ekoppen/ha-personal/bilresa-wandschakelaar/print/B1_blindplaat_1doos/B1_blindplaat_1doos_deel1_basis.3mf

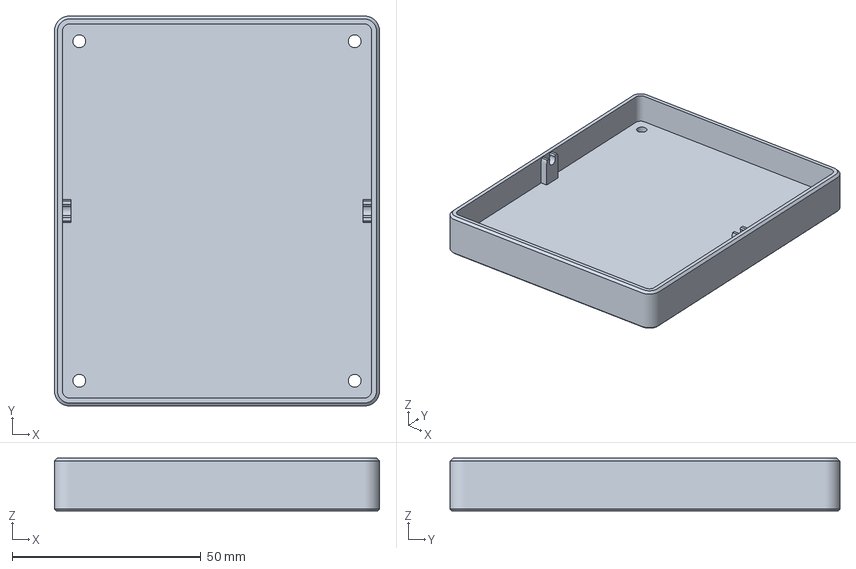
[picture p3: CAD file, 2026-11-01]
bilresa-wandschakelaar/print/B1_blindplaat_1doos/B1_blindplaat_1doos_deel1_basis.3mf
86.2 x 103.4 x 14.1 mm
