ekoppen/ha-personal/bilresa-wandschakelaar/print/D2_montagebakje_2_losse_modules/D2_montagebakje_2_losse_modules.3mf

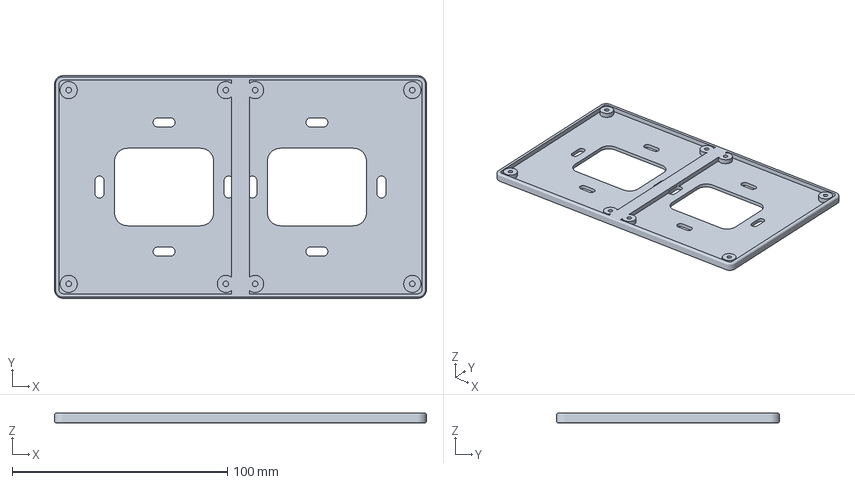
[picture p4: CAD file, 2026-11-01]
bilresa-wandschakelaar/print/D2_montagebakje_2_losse_modules/D2_montagebakje_2_losse_modules.3mf
172.8 x 103.4 x 4.65 mm
