ekoppen/ha-personal/bilresa-wandschakelaar/print/V1_enkel_1doos/STL/5_knop_dopje_normaal.stl

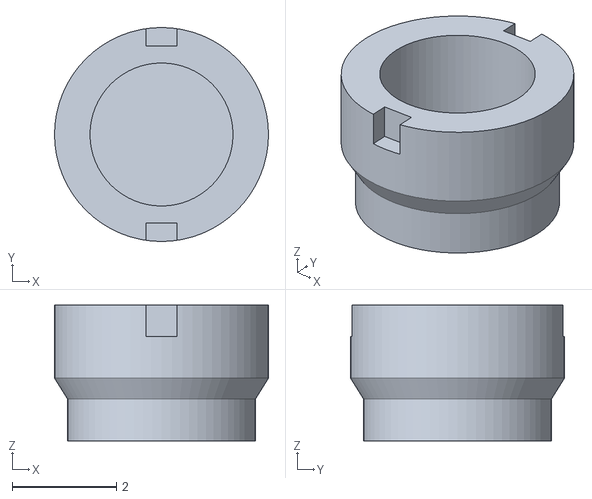
[picture p5: CAD file, 2026-11-01]
bilresa-wandschakelaar/print/V1_enkel_1doos/STL/5_knop_dopje_normaal.stl
4.10 x 4.10 x 2.60
