ekoppen/ha-personal/bilresa-wandschakelaar/print/V1_enkel_1doos/V1_enkel_1doos_deel2_montagebakje.3mf

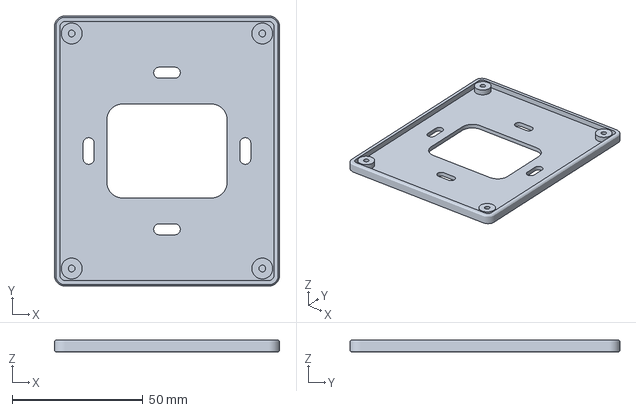
[picture p6: CAD file, 2026-11-01]
bilresa-wandschakelaar/print/V1_enkel_1doos/V1_enkel_1doos_deel2_montagebakje.3mf
86.2 x 103.4 x 4.65 mm
