ekoppen/ha-personal/bilresa-wandschakelaar/print/V2_dubbel_1doos/V2_dubbel_1doos_deel1_basis.3mf

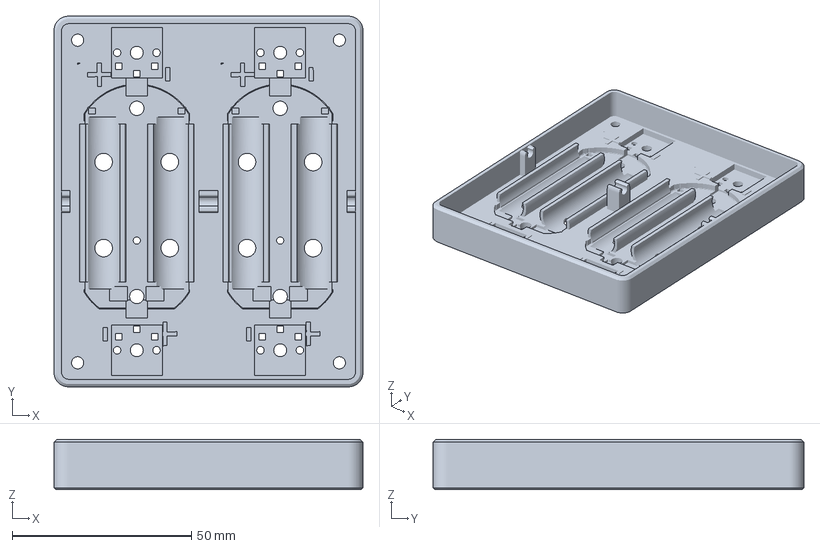
[picture p7: CAD file, 2026-11-01]
bilresa-wandschakelaar/print/V2_dubbel_1doos/V2_dubbel_1doos_deel1_basis.3mf
86.2 x 103.4 x 14.1 mm
