ekoppen/ha-personal/bilresa-wandschakelaar/print/V3_dubbel_2dozen/V3_dubbel_2dozen_deel1_basis.3mf

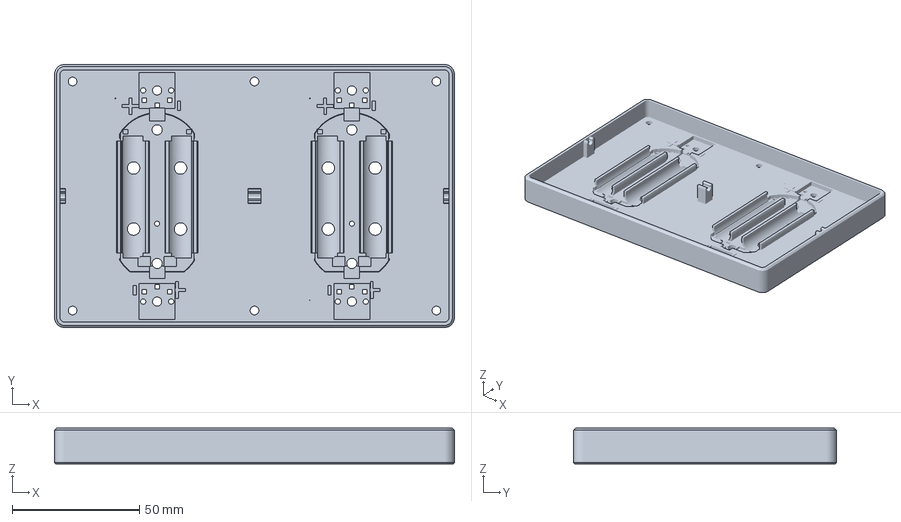
[picture p8: CAD file, 2026-11-01]
bilresa-wandschakelaar/print/V3_dubbel_2dozen/V3_dubbel_2dozen_deel1_basis.3mf
157.2 x 103.4 x 14.1 mm
