ekoppen/ha-personal/bilresa-wandschakelaar/print/V4_vierdubbel_2dozen/STL/4_choc_dopje_normaal.stl

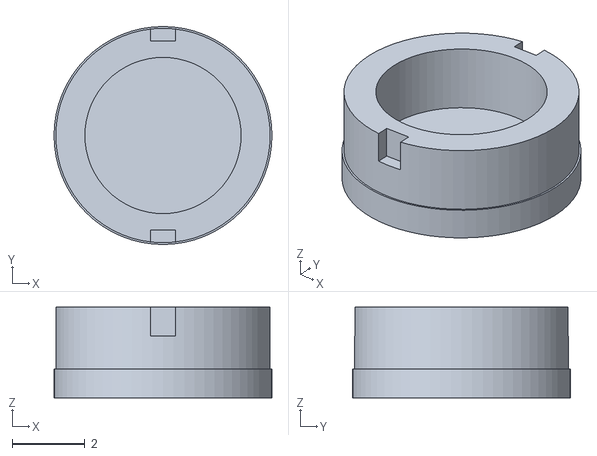
[picture p9: CAD file, 2026-11-01]
bilresa-wandschakelaar/print/V4_vierdubbel_2dozen/STL/4_choc_dopje_normaal.stl
6.00 x 6.00 x 2.50
