ekoppen/ha-personal/bilresa-wandschakelaar/print/V4_vierdubbel_2dozen/V4_vierdubbel_2dozen_deel3_wippen_dopjes_normaal.3mf

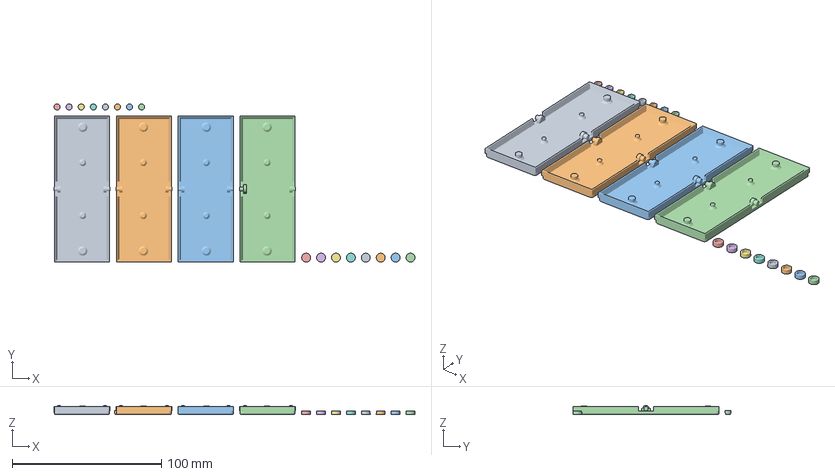
[picture p10: CAD file, 2026-11-01]
bilresa-wandschakelaar/print/V4_vierdubbel_2dozen/V4_vierdubbel_2dozen_deel3_wippen_dopjes_normaal.3mf
242.1 x 106.1 x 6.20 mm
wip1
wip2
wip3
wip4
choc_dopje_normaal_1
choc_dopje_normaal_2
choc_dopje_normaal_3
choc_dopje_normaal_4
choc_dopje_normaal_5
choc_dopje_normaal_6
choc_dopje_normaal_7
choc_dopje_normaal_8
knop_dopje_normaal_1
knop_dopje_normaal_2
knop_dopje_normaal_3
knop_dopje_normaal_4
knop_dopje_normaal_5
knop_dopje_normaal_6
knop_dopje_normaal_7
knop_dopje_normaal_8
