ekoppen/ha-personal/bilresa-wandschakelaar/print/V5_enkel_2dozen_blind/V5_enkel_2dozen_blind_deel1_basis.3mf

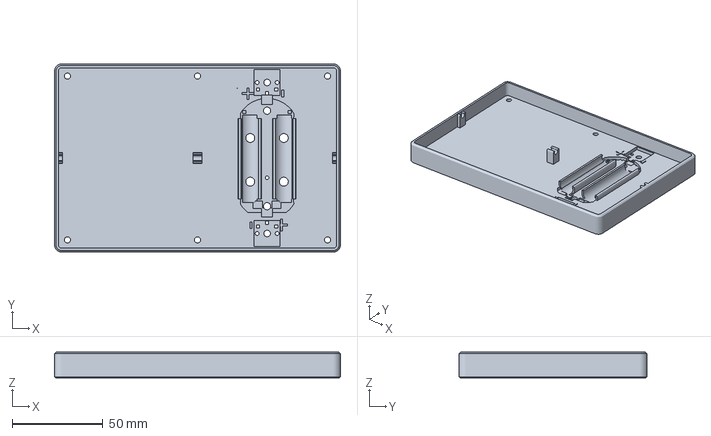
[picture p11: CAD file, 2026-11-01]
bilresa-wandschakelaar/print/V5_enkel_2dozen_blind/V5_enkel_2dozen_blind_deel1_basis.3mf
157.2 x 103.4 x 14.1 mm
