ekoppen/ha-personal/bilresa-wandschakelaar/print/B1_blindplaat_1doos/B1_blindplaat_1doos_deel3_blindplaat.3mf

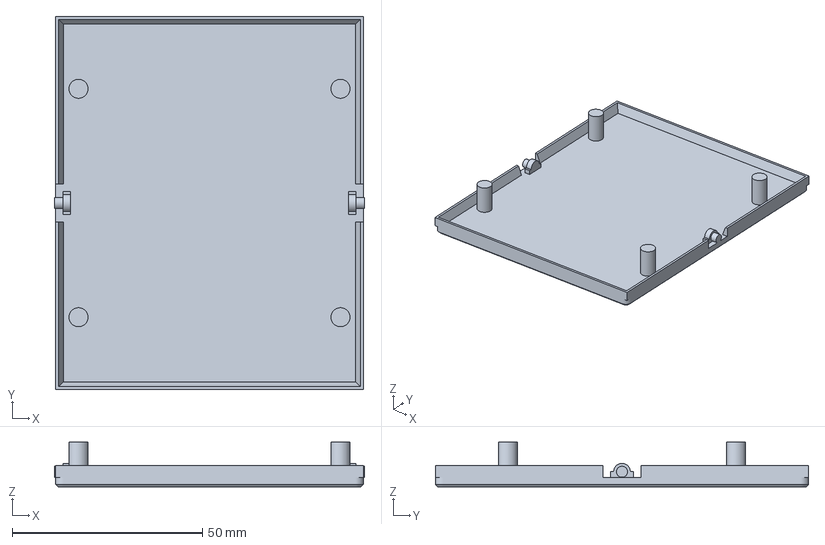
[picture p12: CAD file, 2026-11-01]
bilresa-wandschakelaar/print/B1_blindplaat_1doos/B1_blindplaat_1doos_deel3_blindplaat.3mf
81.4 x 98.0 x 11.8 mm
