ekoppen/ha-personal/bilresa-wandschakelaar/print/V1_enkel_1doos/STL/4_choc_dopje_dun.stl

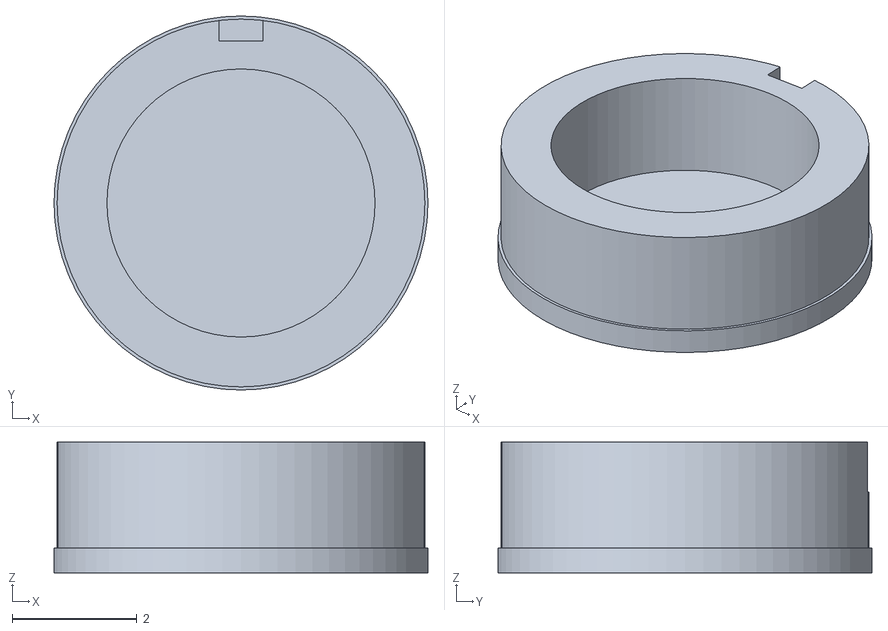
[picture p13: CAD file, 2026-11-01]
bilresa-wandschakelaar/print/V1_enkel_1doos/STL/4_choc_dopje_dun.stl
6.00 x 6.00 x 2.10
