ekoppen/ha-personal/bilresa-wandschakelaar/print/V1_enkel_1doos/V1_enkel_1doos_deel4_reserve_dopjes_dun_dik.3mf

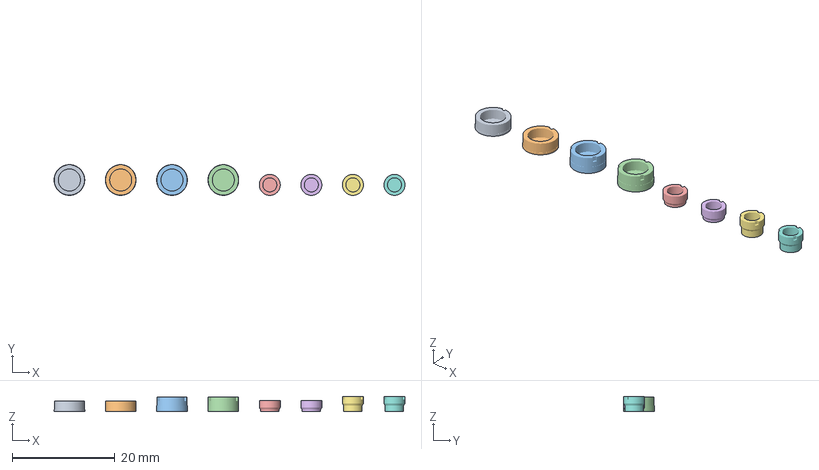
[picture p14: CAD file, 2026-11-01]
bilresa-wandschakelaar/print/V1_enkel_1doos/V1_enkel_1doos_deel4_reserve_dopjes_dun_dik.3mf
68.4 x 6.00 x 3.00 mm
choc_dopje_dun_1
choc_dopje_dun_2
choc_dopje_dik_1
choc_dopje_dik_2
knop_dopje_dun_1
knop_dopje_dun_2
knop_dopje_dik_1
knop_dopje_dik_2
