ekoppen/ha-personal/bilresa-wandschakelaar/print/V2_dubbel_1doos/STL/3_wip_1.stl

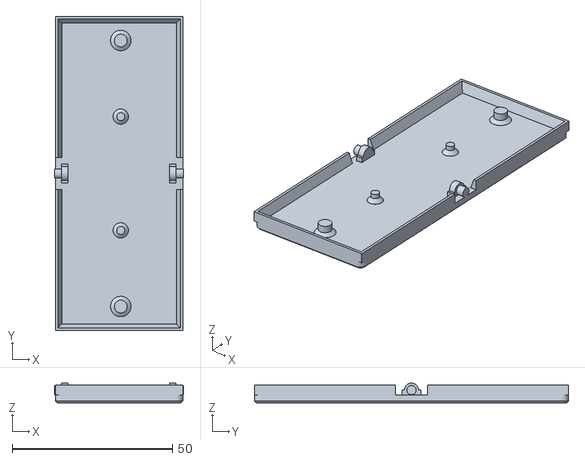
[picture p15: CAD file, 2026-11-01]
bilresa-wandschakelaar/print/V2_dubbel_1doos/STL/3_wip_1.stl
40.3 x 98.0 x 6.20
