ekoppen/ha-personal/bilresa-wandschakelaar/print/V3_dubbel_2dozen/V3_dubbel_2dozen_deel4_reserve_dopjes_dun_dik.3mf

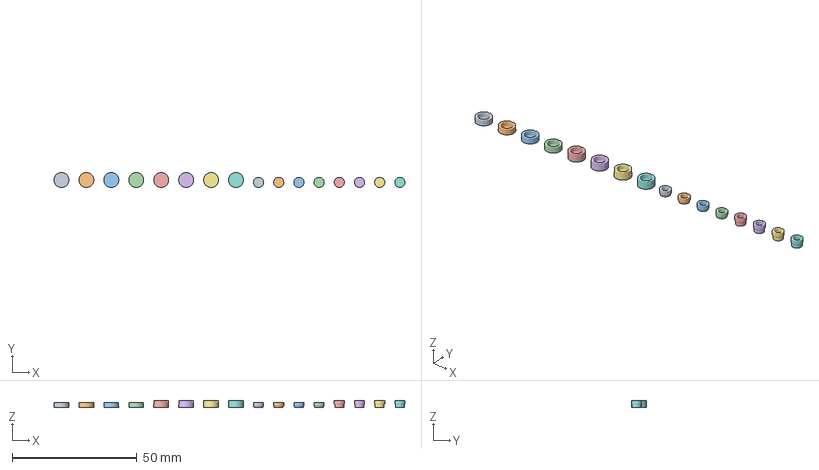
[picture p18: CAD file, 2026-11-01]
bilresa-wandschakelaar/print/V3_dubbel_2dozen/V3_dubbel_2dozen_deel4_reserve_dopjes_dun_dik.3mf
140.8 x 6.00 x 3.00 mm
choc_dopje_dun_1
choc_dopje_dun_2
choc_dopje_dun_3
choc_dopje_dun_4
choc_dopje_dik_1
choc_dopje_dik_2
choc_dopje_dik_3
choc_dopje_dik_4
knop_dopje_dun_1
knop_dopje_dun_2
knop_dopje_dun_3
knop_dopje_dun_4
knop_dopje_dik_1
knop_dopje_dik_2
knop_dopje_dik_3
knop_dopje_dik_4
