ekoppen/ha-personal/bilresa-wandschakelaar/print/V4_vierdubbel_2dozen/STL/2_montagebakje.stl

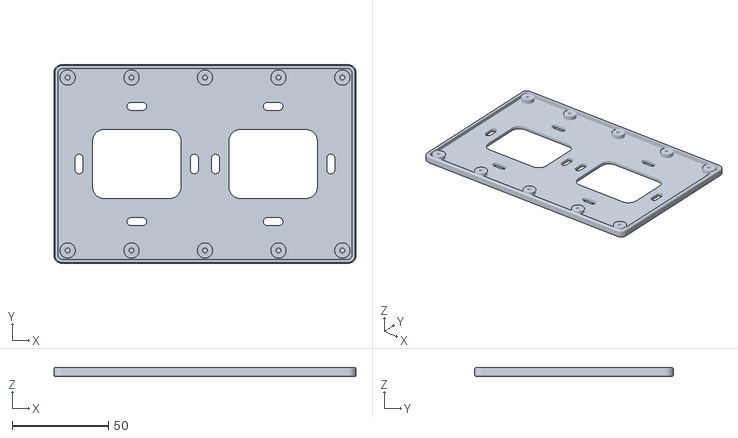
[picture p19: CAD file, 2026-11-01]
bilresa-wandschakelaar/print/V4_vierdubbel_2dozen/STL/2_montagebakje.stl
157.2 x 103.4 x 4.65
