ekoppen/ha-personal/bilresa-wandschakelaar/print/V5_enkel_2dozen_blind/STL/3_wip_2.stl

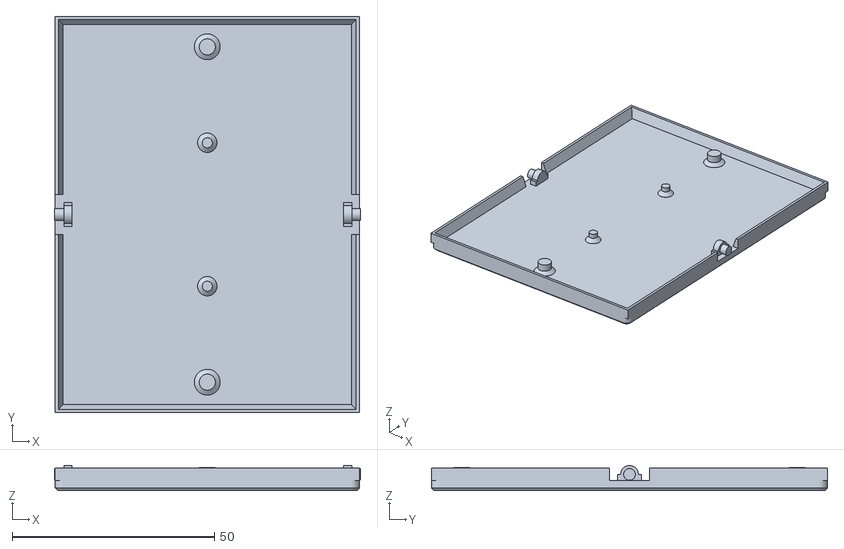
[picture p20: CAD file, 2026-11-01]
bilresa-wandschakelaar/print/V5_enkel_2dozen_blind/STL/3_wip_2.stl
75.8 x 98.0 x 6.20
