ekoppen/ha-personal/bilresa-wandschakelaar/print/V3_dubbel_2dozen/V3_dubbel_2dozen_deel3_wippen_dopjes_normaal.3mf

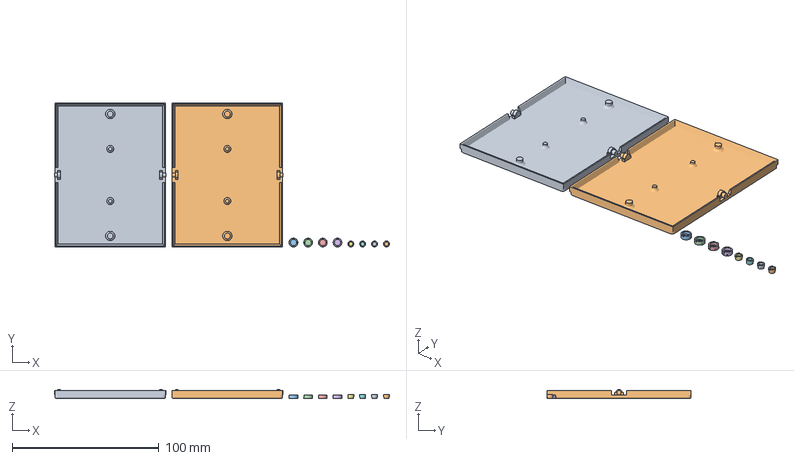
[picture p22: CAD file, 2026-11-01]
bilresa-wandschakelaar/print/V3_dubbel_2dozen/V3_dubbel_2dozen_deel3_wippen_dopjes_normaal.3mf
228.0 x 98.0 x 6.20 mm
wip1
wip2
choc_dopje_normaal_1
choc_dopje_normaal_2
choc_dopje_normaal_3
choc_dopje_normaal_4
knop_dopje_normaal_1
knop_dopje_normaal_2
knop_dopje_normaal_3
knop_dopje_normaal_4
