ekoppen/ha-personal/bilresa-wandschakelaar/print/V4_vierdubbel_2dozen/V4_vierdubbel_2dozen_deel1_basis.3mf

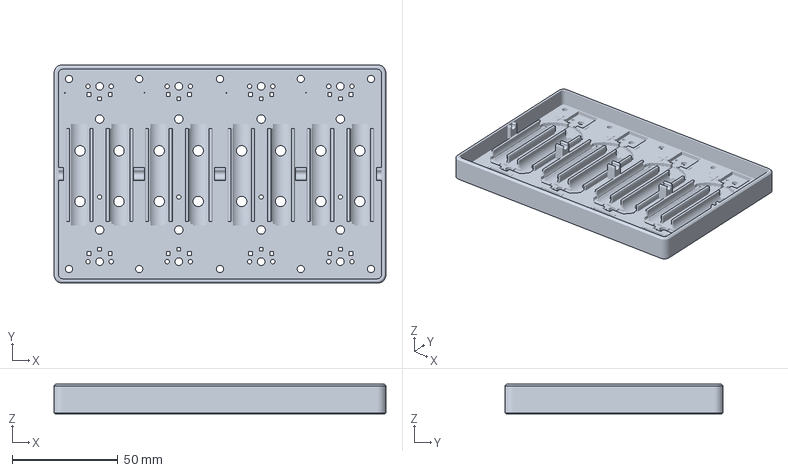
[picture p24: CAD file, 2026-11-01]
bilresa-wandschakelaar/print/V4_vierdubbel_2dozen/V4_vierdubbel_2dozen_deel1_basis.3mf
157.2 x 103.4 x 14.1 mm
