ekoppen/ha-personal/bilresa-wandschakelaar/print/V5_enkel_2dozen_blind/STL/5_knop_dopje_dun.stl

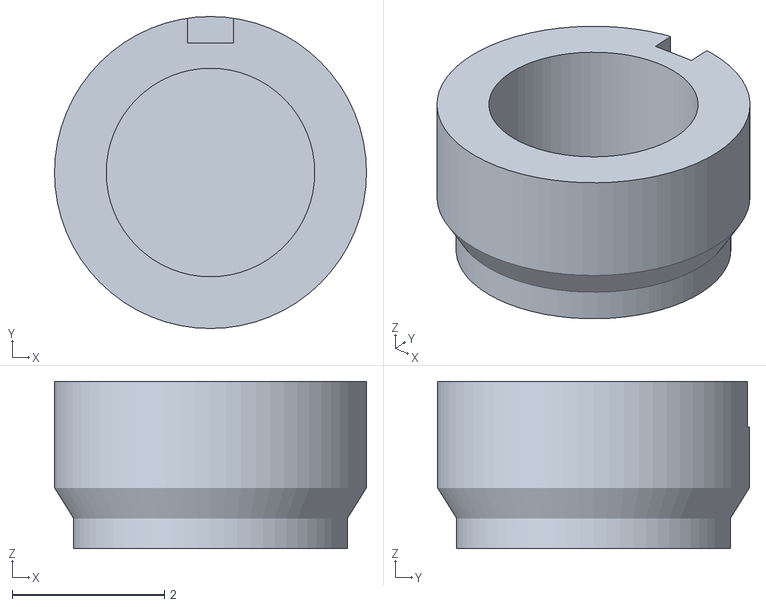
[picture p25: CAD file, 2026-11-01]
bilresa-wandschakelaar/print/V5_enkel_2dozen_blind/STL/5_knop_dopje_dun.stl
4.10 x 4.10 x 2.20
