ekoppen/ha-personal/bilresa-wandschakelaar/print/V1_enkel_1doos/V1_enkel_1doos_deel3_wippen_dopjes_normaal.3mf

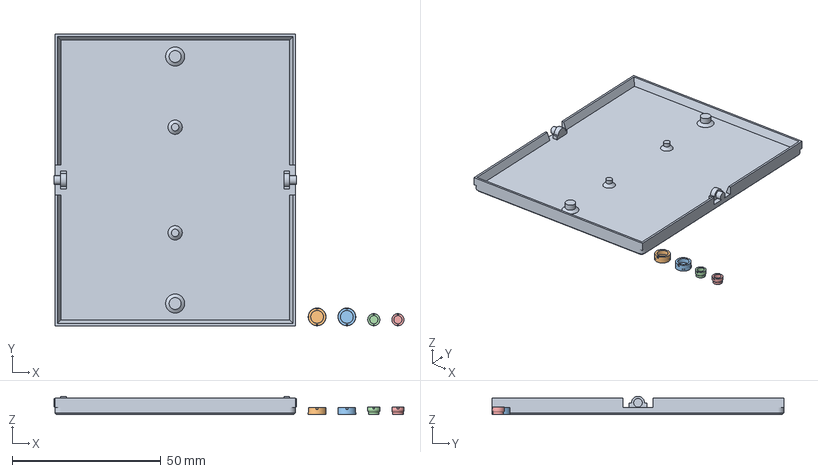
[picture p26: CAD file, 2026-11-01]
bilresa-wandschakelaar/print/V1_enkel_1doos/V1_enkel_1doos_deel3_wippen_dopjes_normaal.3mf
117.6 x 98.0 x 6.20 mm
wip1
choc_dopje_normaal_1
choc_dopje_normaal_2
knop_dopje_normaal_1
knop_dopje_normaal_2
