ekoppen/ha-personal/bilresa-wandschakelaar/print/V4_vierdubbel_2dozen/V4_vierdubbel_2dozen_deel4_reserve_dopjes_dun_dik.3mf

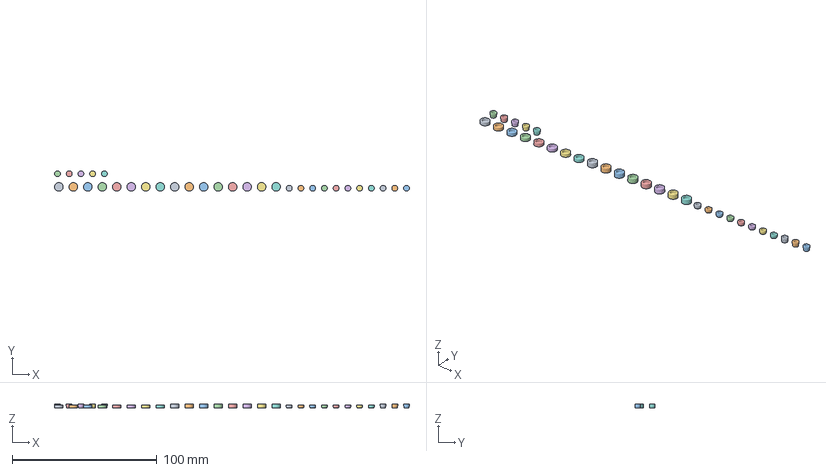
[picture p27: CAD file, 2026-11-01]
bilresa-wandschakelaar/print/V4_vierdubbel_2dozen/V4_vierdubbel_2dozen_deel4_reserve_dopjes_dun_dik.3mf
245.1 x 14.1 x 3.00 mm
choc_dopje_dun_1
choc_dopje_dun_2
choc_dopje_dun_3
choc_dopje_dun_4
choc_dopje_dun_5
choc_dopje_dun_6
choc_dopje_dun_7
choc_dopje_dun_8
choc_dopje_dik_1
choc_dopje_dik_2
choc_dopje_dik_3
choc_dopje_dik_4
choc_dopje_dik_5
choc_dopje_dik_6
choc_dopje_dik_7
choc_dopje_dik_8
knop_dopje_dun_1
knop_dopje_dun_2
knop_dopje_dun_3
knop_dopje_dun_4
knop_dopje_dun_5
knop_dopje_dun_6
knop_dopje_dun_7
knop_dopje_dun_8
knop_dopje_dik_1
knop_dopje_dik_2
knop_dopje_dik_3
knop_dopje_dik_4
knop_dopje_dik_5
knop_dopje_dik_6
knop_dopje_dik_7
knop_dopje_dik_8
