ekoppen/ha-personal/bilresa-wandschakelaar/print/V5_enkel_2dozen_blind/V5_enkel_2dozen_blind_deel3_wippen_dopjes_normaal.3mf

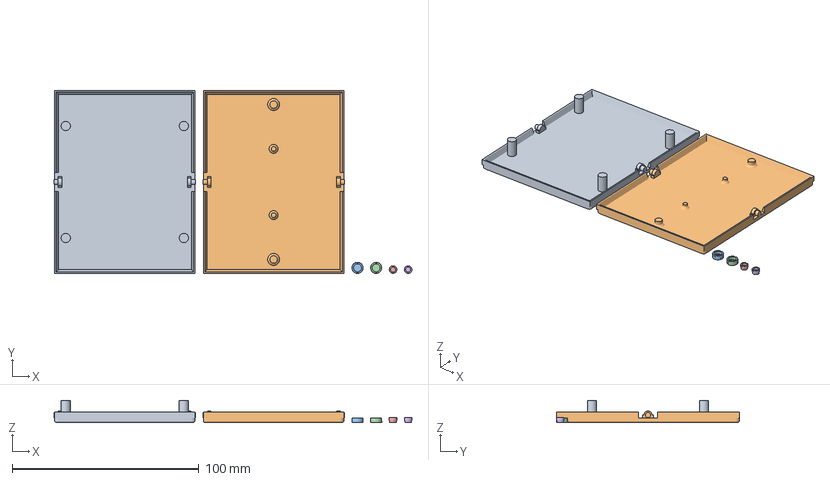
[picture p28: CAD file, 2026-11-01]
bilresa-wandschakelaar/print/V5_enkel_2dozen_blind/V5_enkel_2dozen_blind_deel3_wippen_dopjes_normaal.3mf
191.8 x 98.0 x 11.8 mm
blindplaat1
wip2
choc_dopje_normaal_1
choc_dopje_normaal_2
knop_dopje_normaal_1
knop_dopje_normaal_2
