ekoppen/ha-personal/bilresa-wandschakelaar/print/V2_dubbel_1doos/STL/5_knop_dopje_dik.stl

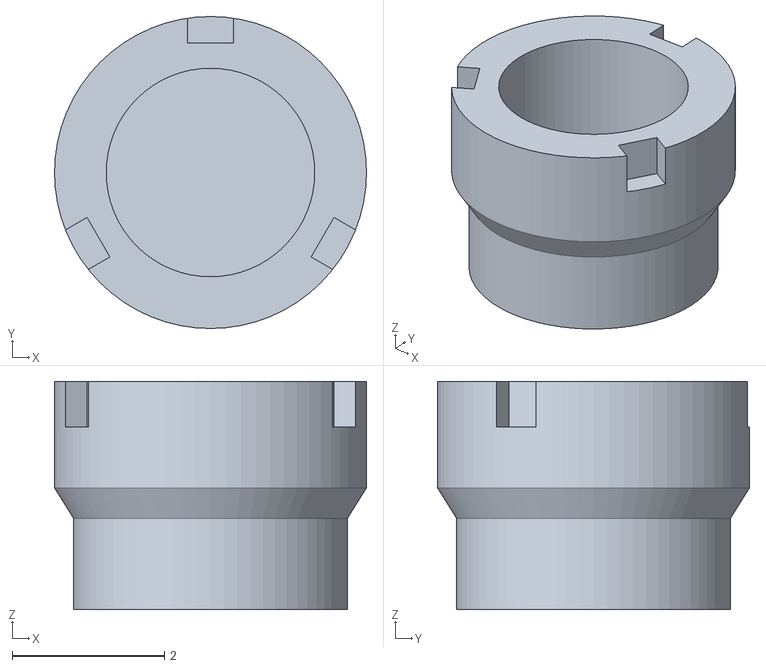
[picture p29: CAD file, 2026-11-01]
bilresa-wandschakelaar/print/V2_dubbel_1doos/STL/5_knop_dopje_dik.stl
4.10 x 4.10 x 3.00
