ekoppen/ha-personal/bilresa-wandschakelaar/print/V1_enkel_1doos/STL/3_wip_1.stl

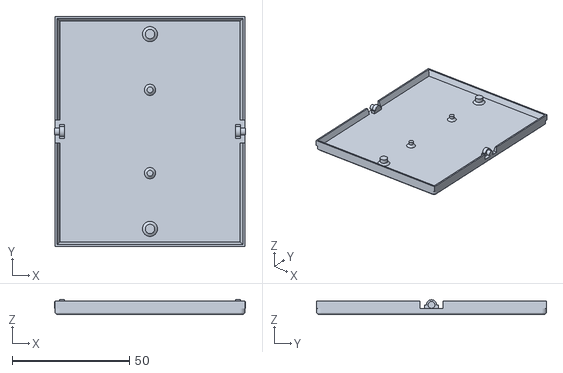
[picture p30: CAD file, 2026-11-01]
bilresa-wandschakelaar/print/V1_enkel_1doos/STL/3_wip_1.stl
81.4 x 98.0 x 6.20
