ekoppen/ha-personal/bilresa-wandschakelaar/print/V4_vierdubbel_2dozen/STL/3_wip_1.stl

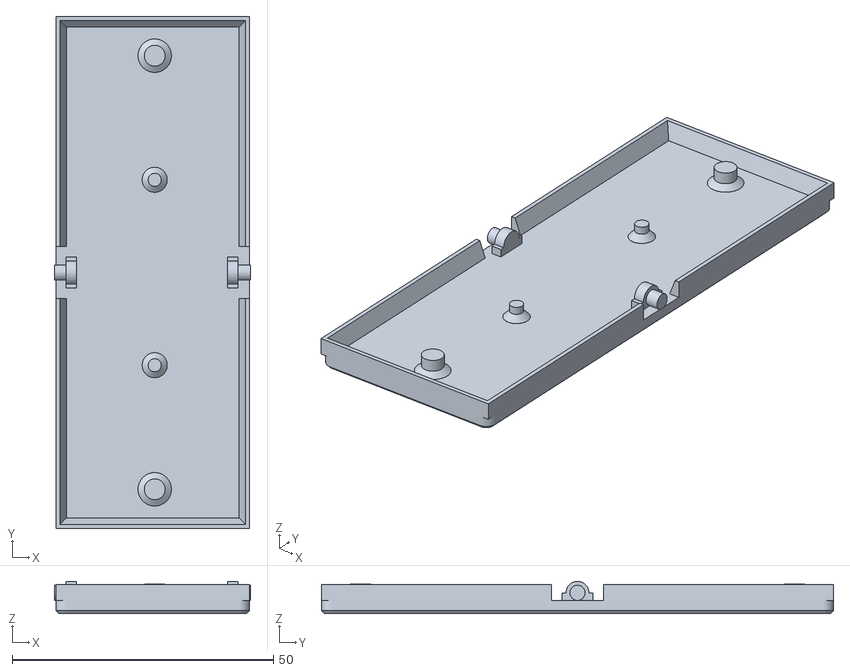
[picture p31: CAD file, 2026-11-01]
bilresa-wandschakelaar/print/V4_vierdubbel_2dozen/STL/3_wip_1.stl
37.6 x 98.0 x 6.20
