ekoppen/ha-personal/bilresa-wandschakelaar/print/V5_enkel_2dozen_blind/STL/3_blindplaat_1.stl

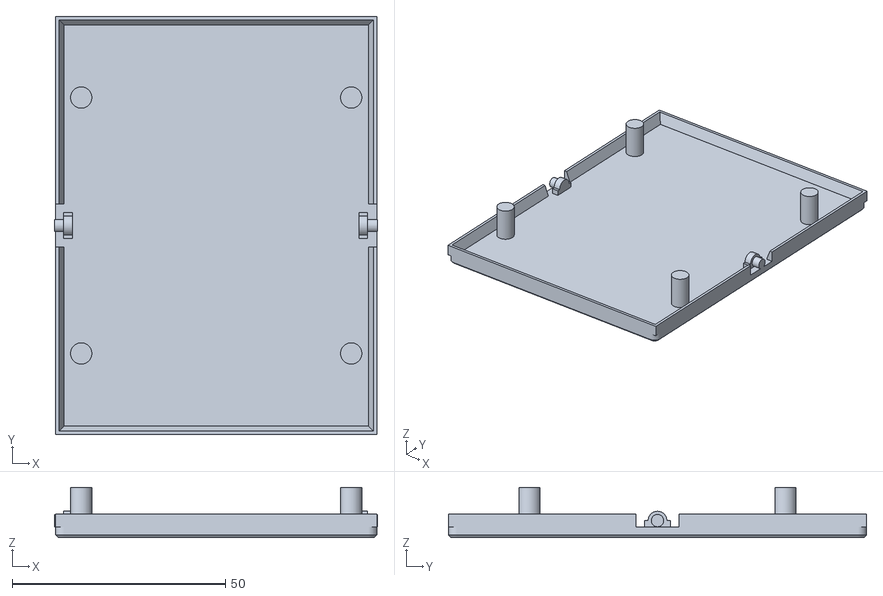
[picture p32: CAD file, 2026-11-01]
bilresa-wandschakelaar/print/V5_enkel_2dozen_blind/STL/3_blindplaat_1.stl
75.8 x 98.0 x 11.8
