ekoppen/ha-personal/bilresa-wandschakelaar/print/V4_vierdubbel_2dozen/STL/3_wip_3.stl

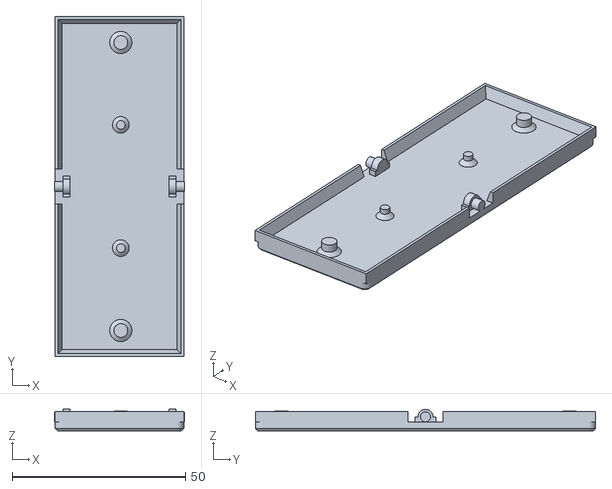
[picture p33: CAD file, 2026-11-01]
bilresa-wandschakelaar/print/V4_vierdubbel_2dozen/STL/3_wip_3.stl
37.5 x 98.0 x 6.20
