ekoppen/ha-personal/(list of files, cad)

Other CAD files:
bilresa-wandschakelaar/print/B1_blindplaat_1doos/STL/1_basis.stl
bilresa-wandschakelaar/print/V2_dubbel_1doos/STL/2_montagebakje.stl
bilresa-wandschakelaar/print/B1_blindplaat_1doos/STL/2_montagebakje.stl
bilresa-wandschakelaar/print/V4_vierdubbel_2dozen/V4_vierdubbel_2dozen_deel2_montagebakje.3mf
bilresa-wandschakelaar/print/V5_enkel_2dozen_blind/V5_enkel_2dozen_blind_deel2_montagebakje.3mf
bilresa-wandschakelaar/print/B1_blindplaat_1doos/B1_blindplaat_1doos_deel2_montagebakje.3mf
bilresa-wandschakelaar/print/B1_blindplaat_1doos/STL/3_blindplaat_1.stl
bilresa-wandschakelaar/print/V2_dubbel_1doos/V2_dubbel_1doos_deel4_reserve_dopjes_dun_dik.3mf
bilresa-wandschakelaar/print/V5_enkel_2dozen_blind/V5_enkel_2dozen_blind_deel4_reserve_dopjes_dun_dik.3mf
bilresa-wandschakelaar/print/V2_dubbel_1doos/V2_dubbel_1doos_deel2_montagebakje.3mf
bilresa-wandschakelaar/print/V3_dubbel_2dozen/V3_dubbel_2dozen_deel2_montagebakje.3mf
bilresa-wandschakelaar/print/V4_vierdubbel_2dozen/STL/1_basis.stl
bilresa-wandschakelaar/print/V1_enkel_1doos/STL/1_basis.stl
bilresa-wandschakelaar/print/V5_enkel_2dozen_blind/STL/1_basis.stl
bilresa-wandschakelaar/print/V2_dubbel_1doos/STL/3_wip_2.stl
bilresa-wandschakelaar/print/V1_enkel_1doos/STL/2_montagebakje.stl
bilresa-wandschakelaar/print/V3_dubbel_2dozen/STL/3_wip_1.stl
bilresa-wandschakelaar/print/V2_dubbel_1doos/STL/1_basis.stl
bilresa-wandschakelaar/print/V3_dubbel_2dozen/STL/1_basis.stl
bilresa-wandschakelaar/print/V4_vierdubbel_2dozen/STL/3_wip_4.stl
bilresa-wandschakelaar/print/V4_vierdubbel_2dozen/STL/3_wip_2.stl
bilresa-wandschakelaar/print/D2_montagebakje_2_losse_modules/D2_montagebakje_2_losse_modules.stl
