ekoppen/ha-personal/bilresa-wandschakelaar/afbeeldingen/basis_en_montagebakje.png

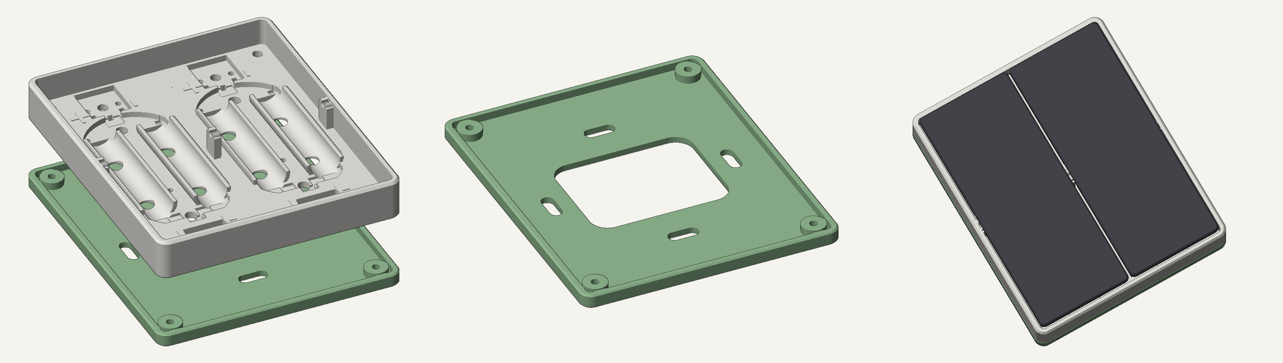
bilresa-wandschakelaar/afbeeldingen/basis_en_montagebakje.png
