ekoppen/ha-personal/bilresa-wandschakelaar/afbeeldingen/D2_breed_montagebakje.png

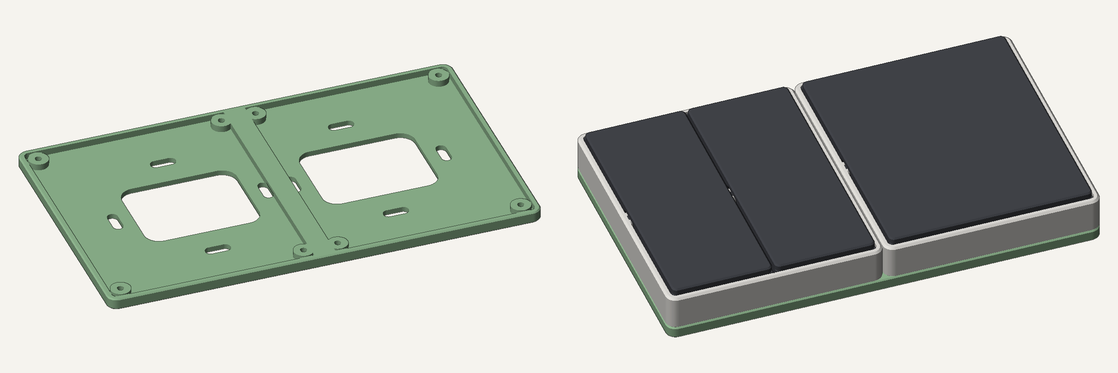
bilresa-wandschakelaar/afbeeldingen/D2_breed_montagebakje.png
