ekoppen/ha-personal/(commit log)

2026-03-07 Add ESP32 combination lock with NeoPixel ring
    Vault-dial style code lock using 12-LED NeoPixel ring with WiFi AP
    captive portal for setup, web config interface, and Home Assistant
    webhook integration.
2026-09-22 Voeg ZHA-blueprint toe voor IKEA BILRESA scroll wheel
    Aan/uit knop plus scrollwiel-dimmen, in dezelfde stijl als de STYRBAR-
    en Hue Dimmer-blueprints. Kleurtemperatuur/hue/volume zitten hier niet
    in - die zijn in ZHA nog niet betrouwbaar te onderscheiden van de
    knop-events.
2026-11-01 Add BILRESA wandschakelaar: 3D-printable wall switch for IKEA BILRESA
    Printable housing for IKEA BILRESA PCBs in European wall boxes with
    Kailh Choc v1 Brown switches for a premium click. Includes print files
    for all variants (single/double box, 1/2/4 rockers, blind plate, wide
    mounting tray), renders, and the Python/manifold3d CAD source.
    Claude-Session: https://claude.ai/code/session_01BLGxzfzkoJp1924Np8ck6W
    [1_basis.stl, 2_montagebakje.stl, 3_blindplaat_1.stl, 3_wip_1.stl, 3_wip_2.stl, 3_wip_3.stl, 3_wip_4.stl, 4_choc_dopje_dik.stl]
